bryanduxbury/atx_bench/v1/README.md

# atx_bench

An digitally-adjustable bench power supply built around an ATX computer power supply.

Check out the DATASHEET for info on features.
