bryanduxbury/atx_bench/(list of files, cad)

Other CAD files:
v1/scad/arduino.scad
