bryanduxbury/atx_bench/v1/eagle/mainboard_v1.brd

## EAGLE design v1/eagle/mainboard_v1.brd (2015-08-13)

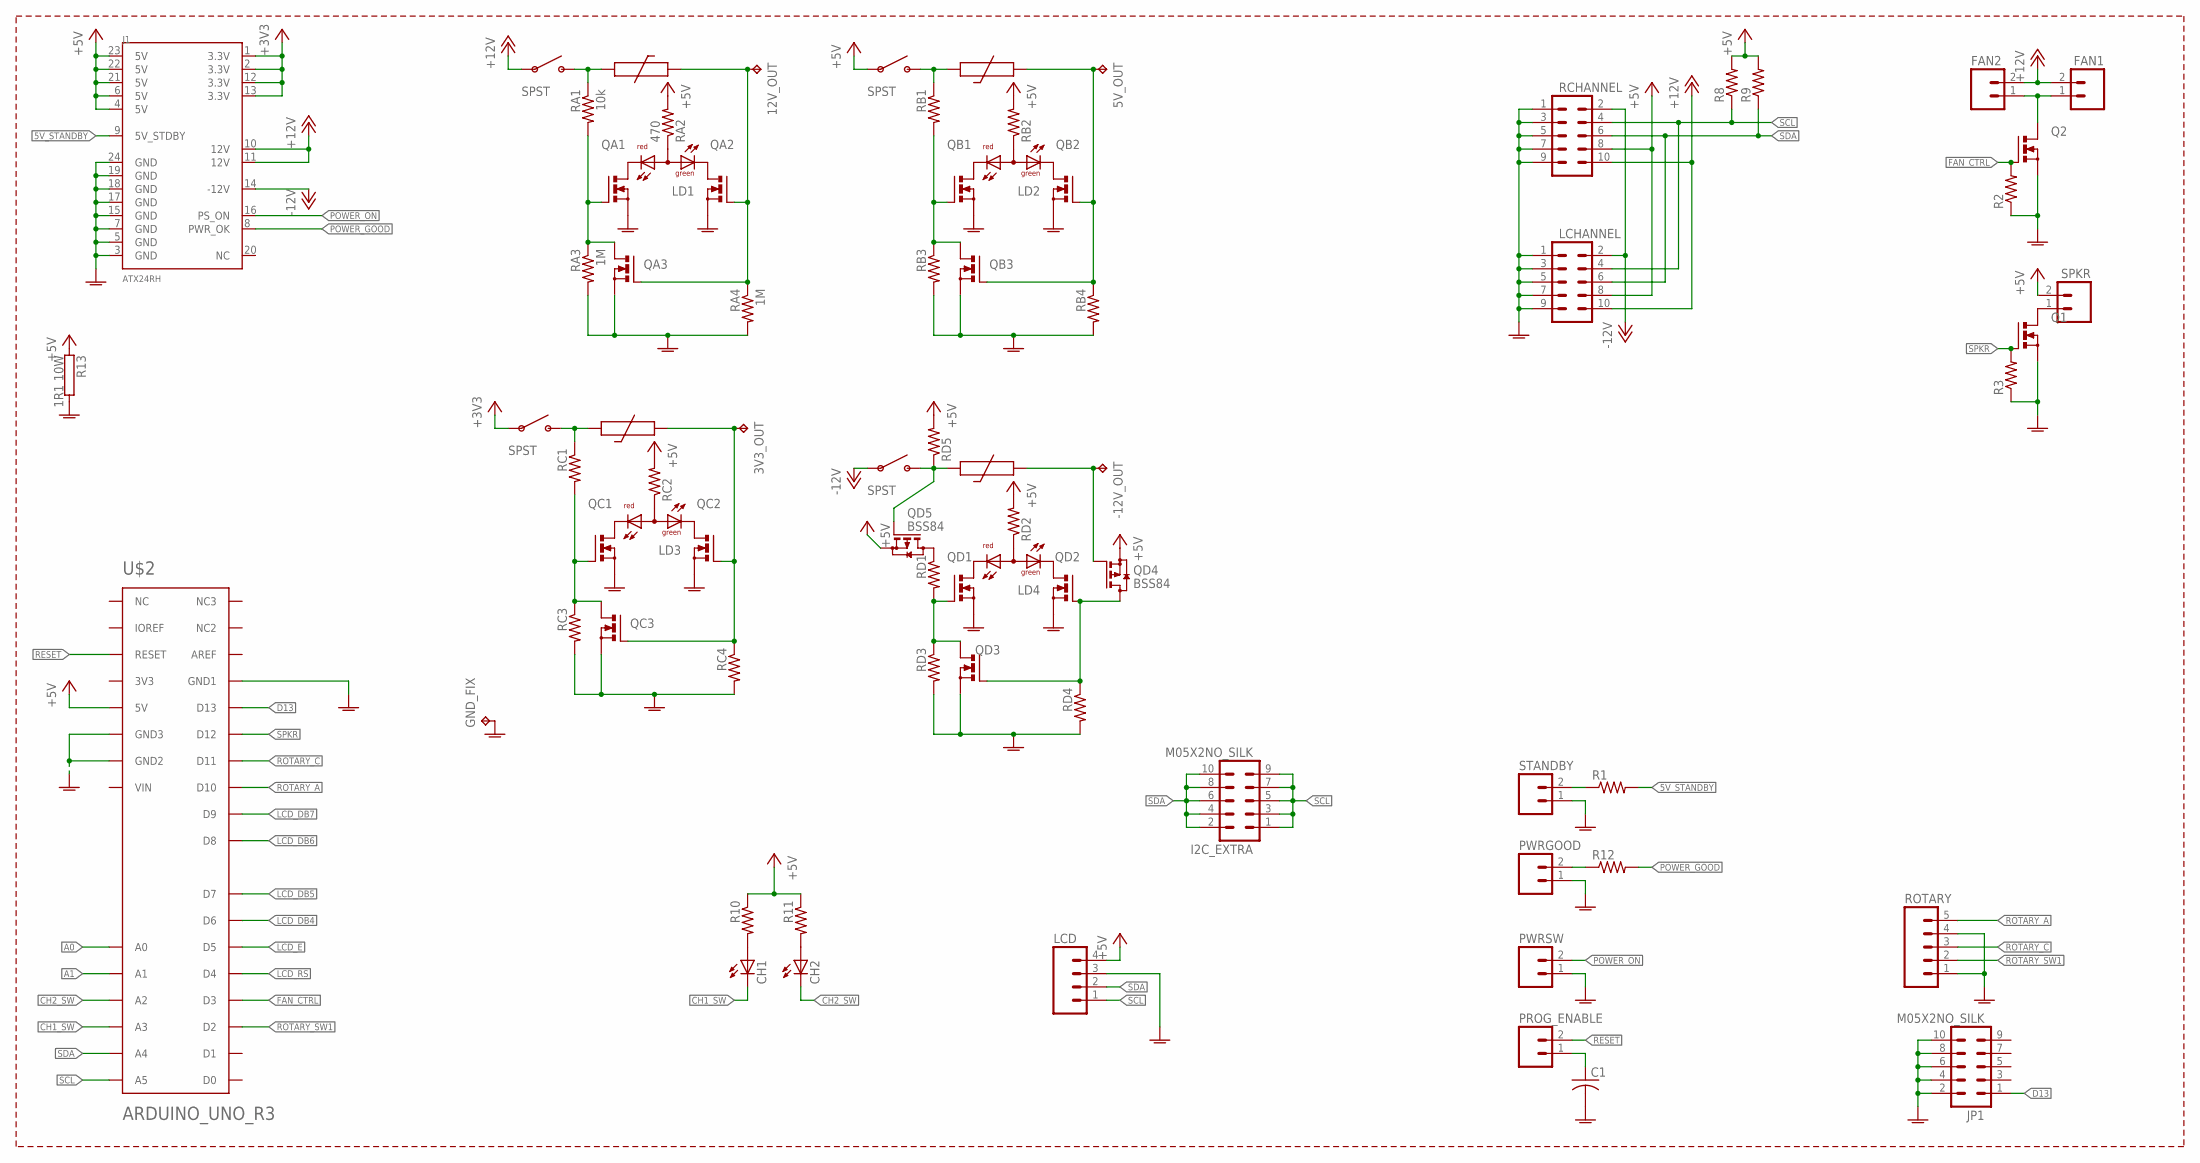
[picture p1: schematic mainboard_v1.sch]

Parts:
3V3_OUT, 5V_OUT, 12V_OUT: TPPAD1-20; P1-20
-12V_OUT: TPPAD1-20; P1-20
C1: C-USC0805; C0805
CH1, CH2: LED5MM
FAN1, FAN2: M02PTH; 1X02
GND_FIX: TPPAD1-20; P1-20
I2C_EXTRA: M05X2NO_SILK; 2X5_NOSILK
J1: ATX24RH; ATX24_RIGHT_ANGLE
JP1: M05X2NO_SILK; 2X5_NOSILK
LCD: M04; 04P
LCHANNEL: M05X2SHD; 2X5-SHROUDED
LD1, LD2, LD3, LD4: DUOLED-RG-A; DUOLED-A-5MM
PROG_ENABLE: M02PTH; 1X02
PWRGOOD: M02PTH; 1X02
PWRSW: M02PTH; 1X02
Q1, Q2: 2N7002L; SOT23
QA1, QA2, QA3: 2N7002L; SOT23
QB1, QB2, QB3: 2N7002L; SOT23
QC1, QC2, QC3: 2N7002L; SOT23
QD1, QD2, QD3: 2N7002L; SOT23
QD4, QD5: BSS84; SOT23
R1, R2, R3, R8, R9, R10, R11, R12: R-US_R0805; R0805
R13: 1R1 10W; MNS-5
RA1: 10k; R0805
RA2: 470; R0805
RA3, RA4: 1M; R0805
RB1, RB2, RB3, RB4: R-US_R0805; R0805
RC1, RC2, RC3, RC4: R-US_R0805; R0805
RCHANNEL: M05X2SHD; 2X5-SHROUDED
RD1, RD2, RD3, RD4, RD5: R-US_R0805; R0805
ROTARY: M05; 05P
SPKR: M02PTH; 1X02
STANDBY: M02PTH; 1X02
U$1, U$3, U$4, U$5: MF-R300; MR-300
U$2: ARDUINO_UNO_R3MINIMUM; ARDUINO_UNO_R3_MIN
U$6, U$8, U$9, U$10: SPST; 2P_REMOTE

Connections:
5V_OUT: 5V_OUT.TP, QB2.1 (G), QB3.1 (G), RB4.1, U$3.P$2 (2)
5V_OUT1: 3V3_OUT.TP, QC2.1 (G), QC3.1 (G), RC4.1, U$4.P$2 (2)
5V_STANDBY: J1.9 (5V_STDBY), R1.2
+3V3: J1.1 (3.3V), J1.2 (3.3V), J1.12 (3.3V), J1.13 (3.3V), U$9.1
+5V: J1.4 (5V), J1.6 (5V), J1.21 (5V), J1.22 (5V), J1.23 (5V), LCD.4, LCHANNEL.8, QD4.2 (S), QD5.2 (S), R8.2, R9.2, R10.1, R11.1, R13.1, RA2.2, RB2.2, RC2.2, RCHANNEL.8, RD2.2, RD5.2, SPKR.2, U$2.5V, U$8.1
+12V: FAN1.2, FAN2.2, J1.10 (12V), J1.11 (12V), LCHANNEL.10, RCHANNEL.10, U$6.1
-12V: J1.14 (-12V), LCHANNEL.2, RCHANNEL.2, U$10.1
A0: U$2.A0
A1: U$2.A1
CH1_SW: CH1.K (C), U$2.A3
CH2_SW: CH2.K (C), U$2.A2
D13: JP1.1, U$2.D13
FAN_CTRL: Q2.1 (G), R2.2, U$2.D3
GNDA: C1.2, GND_FIX.TP, J1.3 (GND), J1.5 (GND), J1.7 (GND), J1.15 (GND), J1.17 (GND), J1.18 (GND), J1.19 (GND), J1.24 (GND), JP1.2, JP1.4, JP1.6, JP1.8, JP1.10, LCD.3, LCHANNEL.1, LCHANNEL.3, LCHANNEL.5, LCHANNEL.7, LCHANNEL.9, PWRGOOD.1, PWRSW.1, Q1.2 (S), Q2.2 (S), QA1.2 (S), QA2.2 (S), QA3.2 (S), QB1.2 (S), QB2.2 (S), QB3.2 (S), QC1.2 (S), QC2.2 (S), QC3.2 (S), QD1.2 (S), QD2.2 (S), QD3.2 (S), R2.1, R3.1, R13.2, RA3.2, RA4.2, RB3.2, RB4.2, RC3.2, RC4.2, RCHANNEL.1, RCHANNEL.3, RCHANNEL.5, RCHANNEL.7, RCHANNEL.9, RD3.2, RD4.2, ROTARY.1, ROTARY.4, STANDBY.1, U$2.GND (GND1), U$2.GND2, U$2.GND3
LCD_DB4: U$2.D6
LCD_DB5: U$2.D7
LCD_DB6: U$2.D8
LCD_DB7: U$2.D9
LCD_E: U$2.D5
LCD_RS: U$2.D4
unnamed: FAN1.1, FAN2.1, Q2.3 (D)
unnamed: R1.1, STANDBY.2
unnamed: Q1.3 (D), SPKR.1
unnamed: CH1.A, R10.2
unnamed: CH2.A, R11.2
unnamed: LD2.A, RB2.1
unnamed: LD1.A, RA2.1
unnamed: LD1.CX (CG), QA2.3 (D)
unnamed: LD1.CR, QA1.3 (D)
unnamed: LD2.CX (CG), QB2.3 (D)
unnamed: LD2.CR, QB1.3 (D)
unnamed: PWRGOOD.2, R12.1
unnamed: C1.1, PROG_ENABLE.1
unnamed: RA1.1, U$1.P$2 (2), U$6.2
unnamed: LD3.CR, QC1.3 (D)
unnamed: LD3.A, RC2.1
unnamed: LD3.CX (CG), QC2.3 (D)
unnamed: QD1.1 (G), QD3.3 (D), RD1.2, RD3.1
unnamed: QD5.3 (D), RD1.1
unnamed: LD4.CR, QD1.3 (D)
unnamed: 12V_OUT.TP, QA2.1 (G), QA3.1 (G), RA4.1, U$1.P$1 (1)
unnamed: QB1.1 (G), QB3.3 (D), RB1.2, RB3.1
unnamed: RB1.1, U$3.P$1 (1), U$8.2
unnamed: LD4.A, RD2.1
unnamed: QA1.1 (G), QA3.3 (D), RA1.2, RA3.1
unnamed: LD4.CX (CG), QD2.3 (D)
unnamed: QC1.1 (G), QC3.3 (D), RC1.2, RC3.1
unnamed: RC1.1, U$4.P$1 (1), U$9.2
unnamed: -12V_OUT.TP, QD4.1 (G), U$5.P$2 (2)
unnamed: QD5.1 (G), RD5.1, U$5.P$1 (1), U$10.2
unnamed: QD2.1 (G), QD3.1 (G), QD4.3 (D), RD4.1
POWER_GOOD: J1.8 (PWR_OK), R12.2
POWER_ON: J1.16 (PS_ON), PWRSW.2
RESET: PROG_ENABLE.2, U$2.RESET
ROTARY_A: ROTARY.5, U$2.D10
ROTARY_C: ROTARY.3, U$2.D11
ROTARY_SW1: ROTARY.2, U$2.D2
SCL: I2C_EXTRA.1, I2C_EXTRA.3, I2C_EXTRA.5, I2C_EXTRA.7, I2C_EXTRA.9, LCD.1, LCHANNEL.4, R8.1, RCHANNEL.4, U$2.A5
SDA: I2C_EXTRA.2, I2C_EXTRA.4, I2C_EXTRA.6, I2C_EXTRA.8, I2C_EXTRA.10, LCD.2, LCHANNEL.6, R9.1, RCHANNEL.6, U$2.A4
SPKR: Q1.1 (G), R3.2, U$2.D12

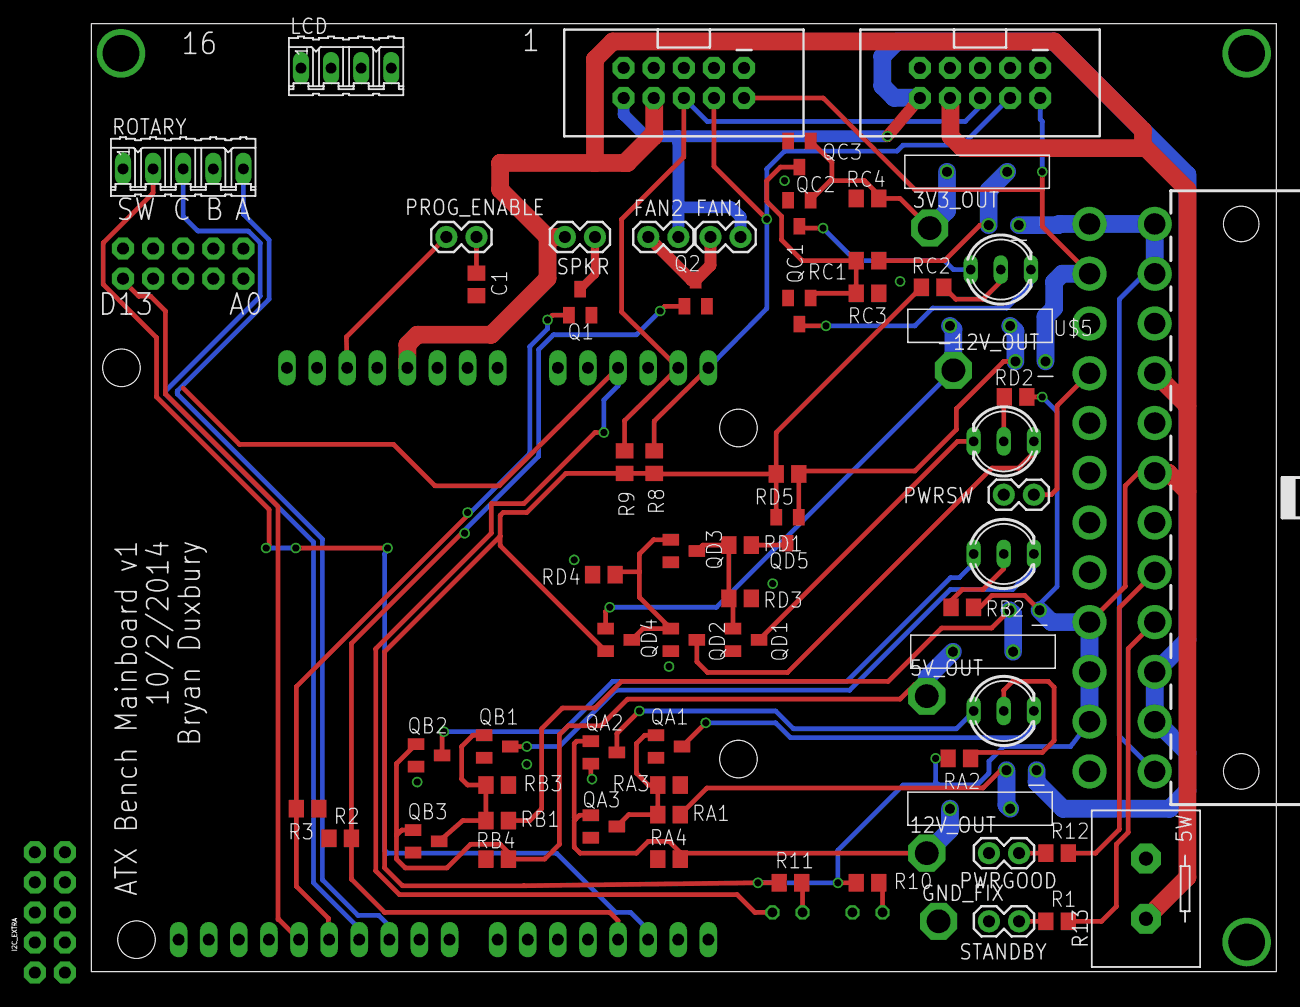
[picture p2: board mainboard_v1.brd from above]

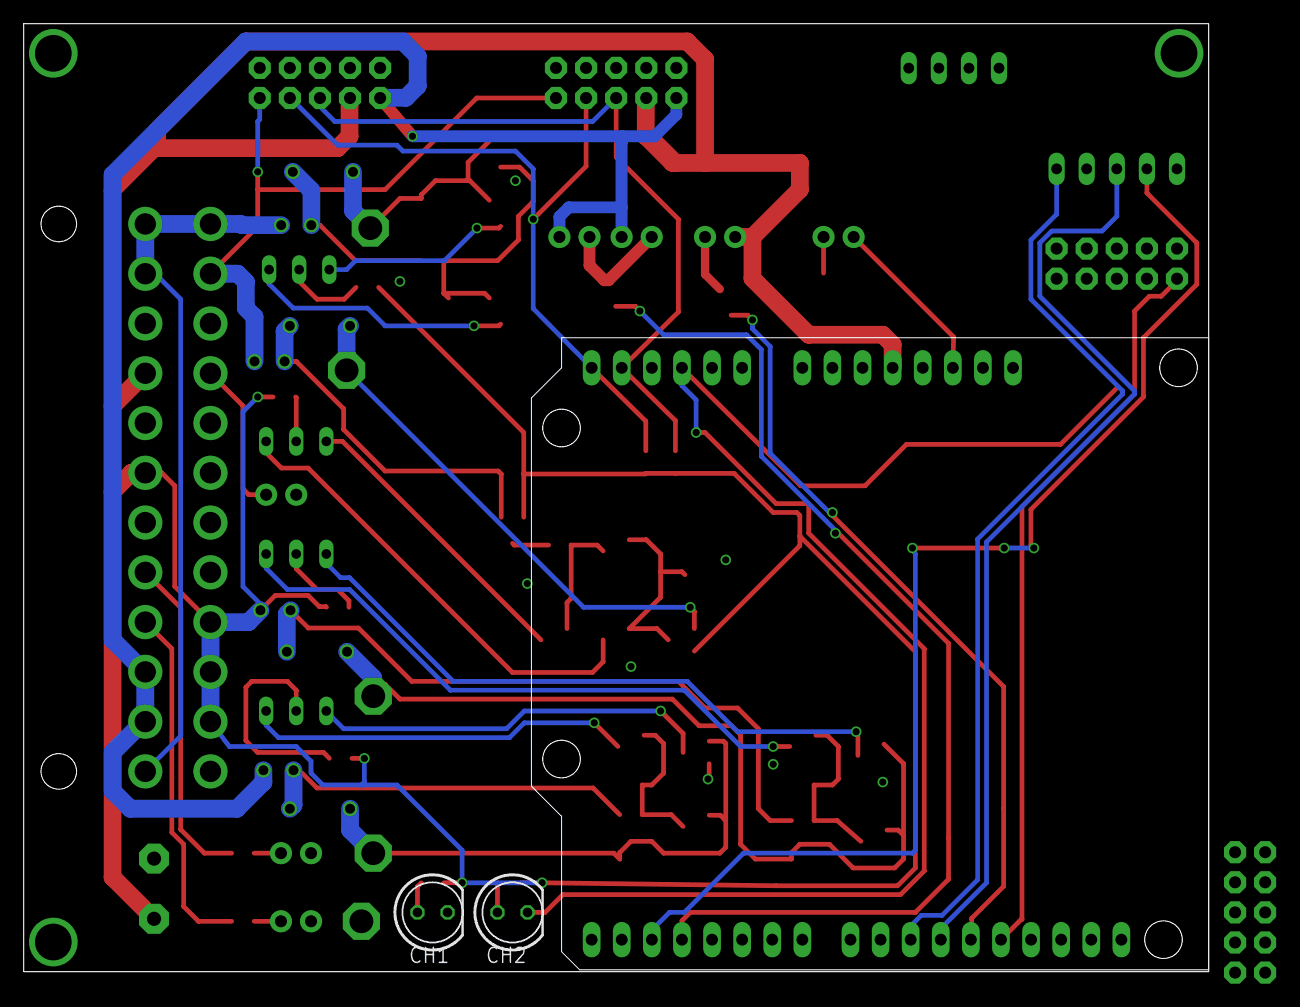
[picture p3: board mainboard_v1.brd from below]

Board: 2 copper layers, 100.0 x 80.0 mm, 77 parts (3 on the bottom side), 52 nets.
