bryanduxbury/atx_bench/v1/eagle/frontend_v1.brd

## EAGLE design v1/eagle/frontend_v1.brd (2014-10-03)

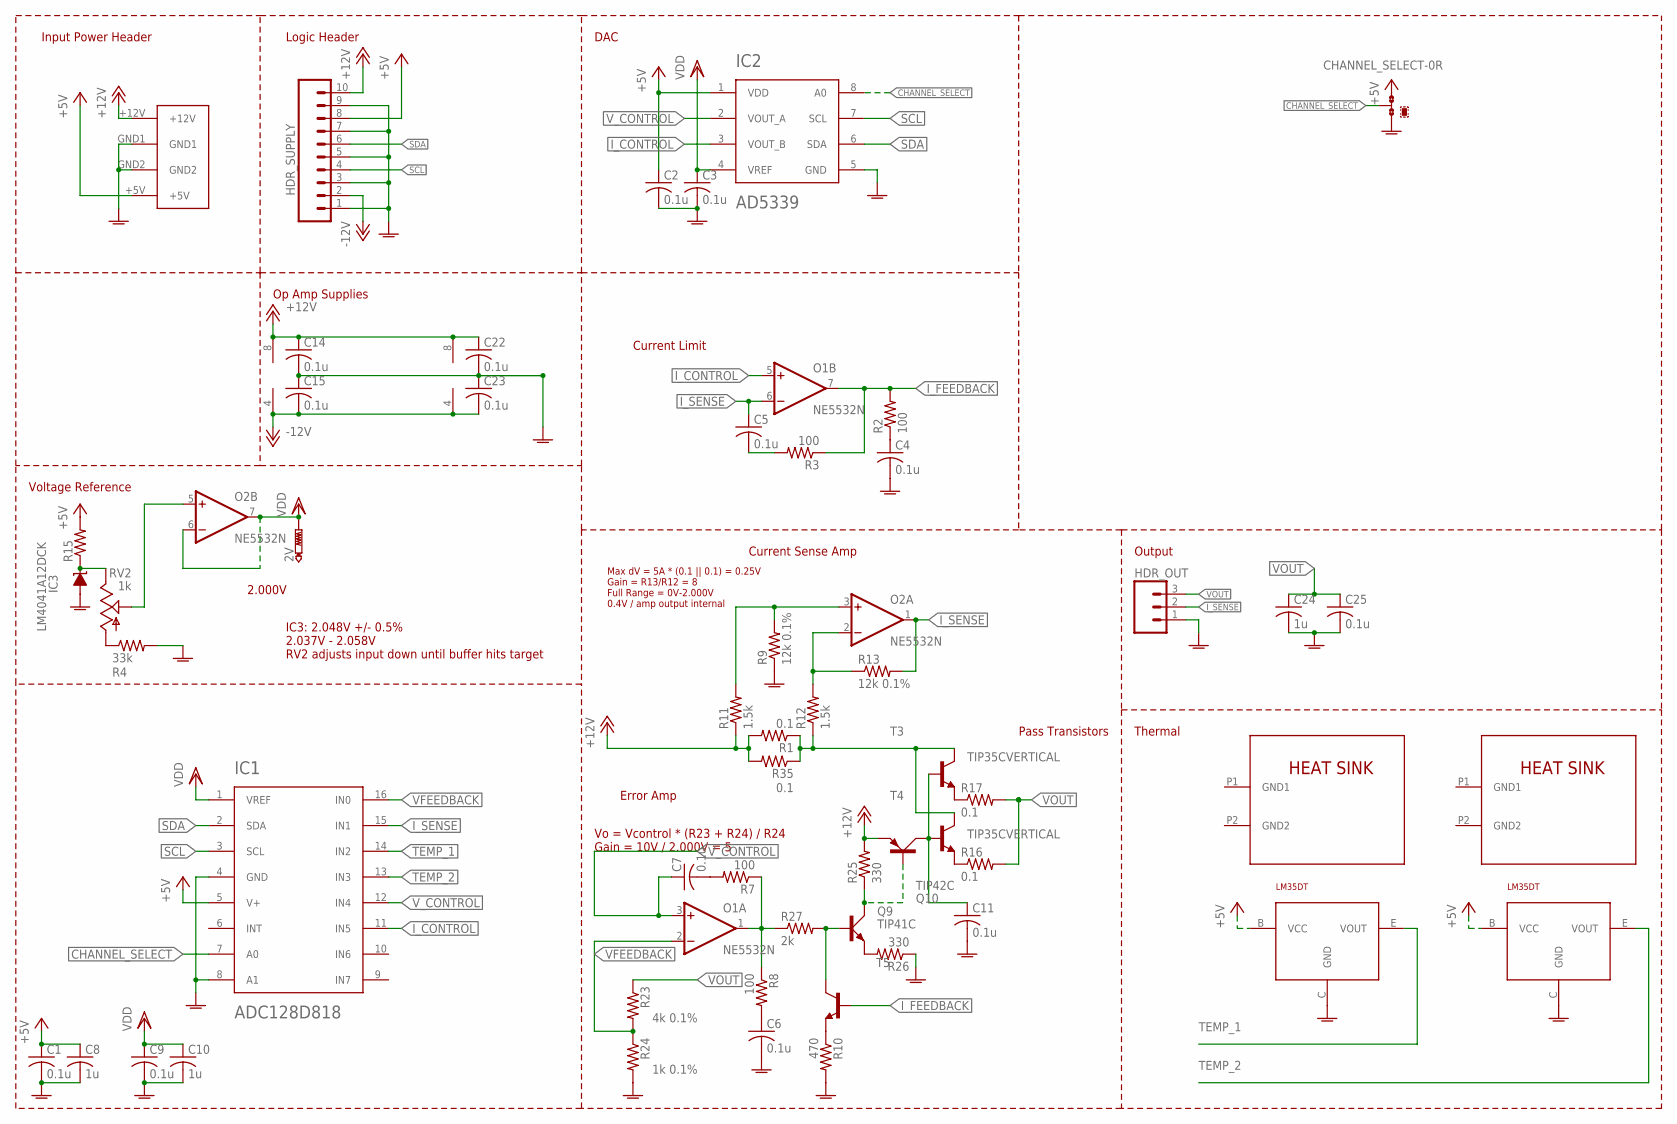
[picture p4: schematic frontend_v1.sch]

Parts:
2V: PTR1PAD1-17; P1-17
C1, C2, C3, C4, C5, C6, C7, C9, C11, C14, C15, C22, C23: 0.1u; C0805
C8, C10: 1u; C0805
C24: 1u; C1206
C25: 0.1u; C1206
CHANNEL_SELECT: 0R-JUMPA; A0R-JMP
HDR_OUT: M03; 03P
HDR_SUPPLY: M10; 10P
IC1: ADC128D818; TSSOP16
IC2: AD5339MSOP8; MSOP08
IC3: LM4041A12DCK; DCK_R-PDSO-G5
O1, O2: NE5532N; DIL08
Q9: TIP41C; TO220AV
Q10: TIP42C; TO220AV
R1, R16, R17, R35: 0.1; R2512
R2, R3, R7, R8: 100; M0805
R4: 33k; M0805
R9, R13: 12k 0.1%; M0805
R10: 470; M0805
R11, R12: 1.5k; M0805
R15: R-US_M0805; M0805
R23: 4k 0.1%; M0805
R24: 1k 0.1%; M0805
R25, R26: 330; M0805
R27: 2k; M0805
RV2: 1k; TRIM_POT
T3, T4: TIP35CVERTICAL; TO247
T5: MMBT2222ALT1-NPN-SOT23-BEC; SOT23-BEC
U2, U3: LM35DT; TO220AV
U$1: MOLEX-8981; MOLEX-8981-MALE
U$2, U$3: FA-T220-X

Connections:
+5V: C1.1, C2.1, C8.1, CHANNEL_SELECT.3, HDR_SUPPLY.8, IC1.5 (V+), IC2.1 (VDD), R15.2, U2.B (VCC), U3.B (VCC), U$1.+5V
+12V: C14.1, C22.1, HDR_SUPPLY.10, O1.8 (V+), O2.8 (V+), Q10.E, R1.2, R11.1, R25.2, R35.2, U$1.+12V
-12V: C15.2, C23.2, HDR_SUPPLY.2, O1.4 (V-), O2.4 (V-)
CHANNEL_SELECT: CHANNEL_SELECT.2, IC1.7 (A0), IC2.8 (A0)
GNDA: C1.2, C2.2, C3.2, C4.2, C6.2, C8.2, C9.2, C10.2, C11.2, C14.2, C15.1, C22.2, C23.1, C24.2, C25.2, CHANNEL_SELECT.1, HDR_OUT.1, HDR_SUPPLY.1, HDR_SUPPLY.3, HDR_SUPPLY.5, HDR_SUPPLY.7, HDR_SUPPLY.9, IC1.4 (GND), IC1.8 (A1), IC2.5 (GND), IC3.1 (A), R4.2, R9.1, R10.2, R24.2, R26.1, U2.C (GND), U3.C (GND), U$1.GND1, U$1.GND2
I_CONTROL: IC1.11 (IN5), IC2.3 (VOUT_B), O1.5 (+IN)
I_FEEDBACK: O1.7 (OUT), R2.2, R3.1, T5.B
I_SENSE: C5.1, HDR_OUT.2, IC1.15 (IN1), O1.6 (-IN), O2.1 (OUT), R13.2
unnamed: C4.1, R2.1
unnamed: C5.2, R3.2
unnamed: O2.5 (+IN), RV2.1 (S)
unnamed: R4.1, RV2.3 (A)
unnamed: C6.1, R8.2
unnamed: Q9.B, R27.2, T5.C
unnamed: C7.2, R7.2
unnamed: O2.3 (+IN), R9.2, R11.2
unnamed: O2.2 (-IN), R12.2, R13.1
unnamed: R10.1, T5.E
unnamed: R16.1, T4.P3 (E)
unnamed: R17.1, T3.P3 (E)
unnamed: R1.1, R12.1, R35.1, T3.P2 (C), T4.P2 (C)
unnamed: Q9.C, Q10.B, R25.1
unnamed: Q9.E, R26.2
unnamed: O1.1 (OUT), R7.1, R8.1, R27.1
unnamed: IC3.3 (C), R15.1, RV2.2 (E)
SCL: HDR_SUPPLY.4, IC1.3 (SCL), IC2.7 (SCL)
SDA: HDR_SUPPLY.6, IC1.2 (SDA), IC2.6 (SDA)
TEMP_1: IC1.14 (IN2), U2.E (VOUT)
TEMP_2: IC1.13 (IN3), U3.E (VOUT)
VDD: 2V.TP, C3.1, C9.1, C10.1, IC1.1 (VREF), IC2.4 (VREF), O2.6 (-IN), O2.7 (OUT)
VFEEDBACK: IC1.16 (IN0), O1.2 (-IN), R23.2, R24.1
VOUT: C24.1, C25.1, HDR_OUT.3, R16.2, R17.2, R23.1
VREF: C11.1, Q10.C, T3.P1 (B), T4.P1 (B)
V_CONTROL: C7.1, IC1.12 (IN4), IC2.2 (VOUT_A), O1.3 (+IN)

Notes on the sheet:
Logic Header
Voltage Reference
Op Amp Supplies
Current Sense Amp
Error Amp
Pass Transistors
Current Limit
Output
Input Power Header
2.000V
Thermal
Max dV = 5A * (0.1 || 0.1) = 0.25V Gain = R13/R12 = 8 Full Range = 0V-2.000V 0.4V / amp output internal
IC3: 2.048V +/- 0.5% 2.037V - 2.058V RV2 adjusts input down until buffer hits target
Vo = Vcontrol * (R23 + R24) / R24 Gain = 10V / 2.000V = 5
DAC

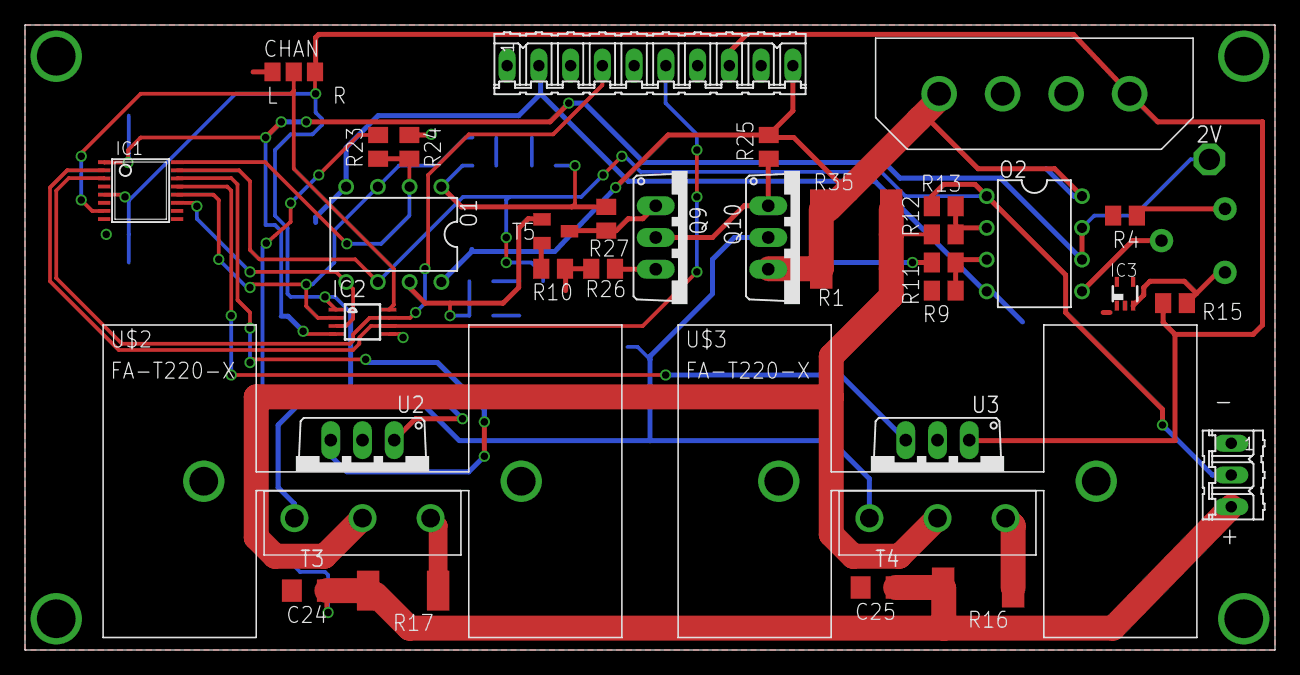
[picture p5: board frontend_v1.brd from above]

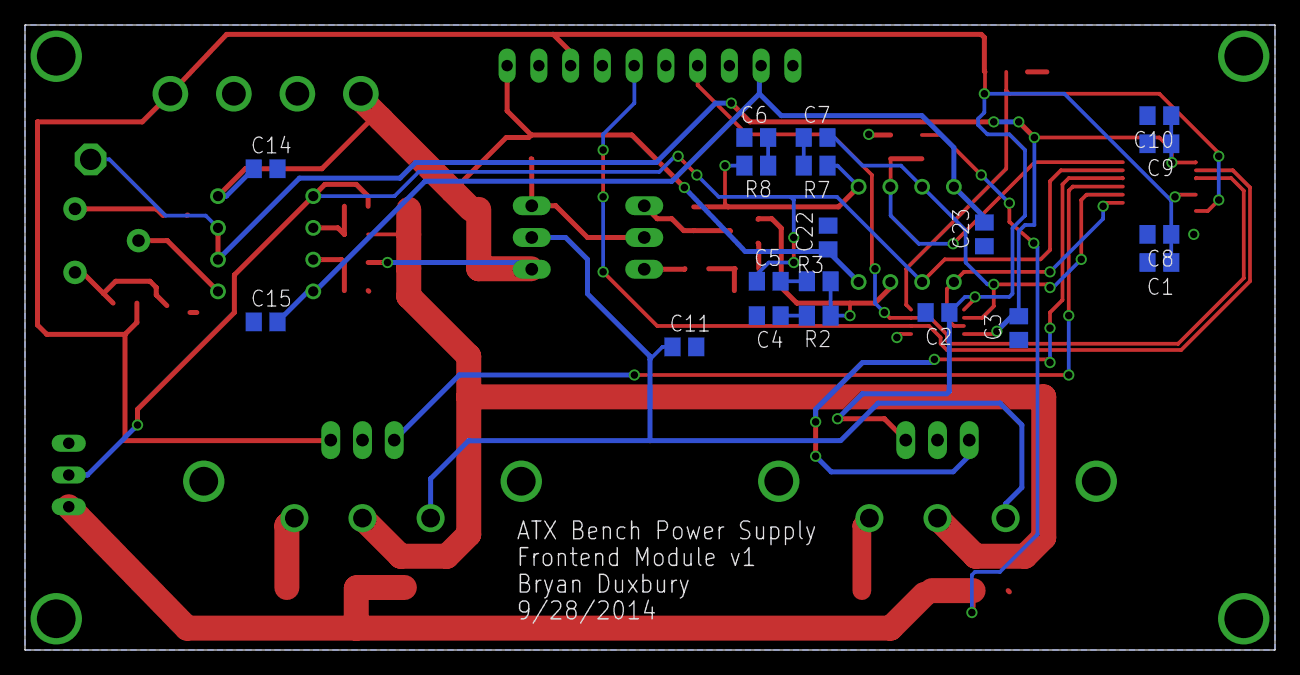
[picture p6: board frontend_v1.brd from below]

Board: 2 copper layers, 100.0 x 50.0 mm, 57 parts (19 on the bottom side), 34 nets.
