bryanduxbury/atx_bench/v1/dac_test/dac_test.ino

#define DAC_OUT 10

void setup() {
  pinMode(DAC_OUT, OUTPUT);
  analogReference(EXTERNAL);
  setPwmFrequency(DAC_OUT, 1);
  
  Serial.begin(115200);
}

void loop() {
  // sweepAndMeasureTest();
  serialControlTest();
}

void sweepAndMeasureTest() {
  while(1) {
    for (int i = 0; i < 256; i++) {
      Serial.print(i);

      analogWrite(DAC_OUT, i);

      for (int sampleNum = 0; sampleNum < 10; sampleNum++) {
        int measurement = analogRead(0);
        Serial.print(",");
        Serial.print(measurement);
        delay(100);
      }
      Serial.println();

      delay(100);
    }
  }
}

void serialControlTest() {
  int val = 0;
  analogWrite(DAC_OUT, val);

  while (1) {
    if (Serial.available() > 0) {
      switch ((char)Serial.read()) {
        case 'k':
          if (val < 255) {
            val ++;
          }
          break;

        case 'j': 
          if (val > 0) {
            val --;
          }
          break;
        
        default: 
          Serial.println("unrecognized!");
          break;
      }
      Serial.println(val);
      analogWrite(DAC_OUT, val);
    }
    delay(20);
  }
}

/**
 * Divides a given PWM pin frequency by a divisor.
 * 
 * The resulting frequency is equal to the base frequency divided by
 * the given divisor:
 *   - Base frequencies:
 *      o The base frequency for pins 3, 9, 10, and 11 is 31250 Hz.
 *      o The base frequency for pins 5 and 6 is 62500 Hz.
 *   - Divisors:
 *      o The divisors available on pins 5, 6, 9 and 10 are: 1, 8, 64,
 *        256, and 1024.
 *      o The divisors available on pins 3 and 11 are: 1, 8, 32, 64,
 *        128, 256, and 1024.
 * 
 * PWM frequencies are tied together in pairs of pins. If one in a
 * pair is changed, the other is also changed to match:
 *   - Pins 5 and 6 are paired on timer0
 *   - Pins 9 and 10 are paired on timer1
 *   - Pins 3 and 11 are paired on timer2
 * 
 * Note that this function will have side effects on anything else
 * that uses timers:
 *   - Changes on pins 3, 5, 6, or 11 may cause the delay() and
 *     millis() functions to stop working. Other timing-related
 *     functions may also be affected.
 *   - Changes on pins 9 or 10 will cause the Servo library to function
 *     incorrectly.
 * 
 * Thanks to macegr of the Arduino forums for his documentation of the
 * PWM frequency divisors. His post can be viewed at:
 *   http://www.arduino.cc/cgi-bin/yabb2/YaBB.pl?num=1235060559/0#4
 */
void setPwmFrequency(int pin, int divisor) {
  byte mode;
  if(pin == 5 || pin == 6 || pin == 9 || pin == 10) {
    switch(divisor) {
      case 1: mode = 0x01; break;
      case 8: mode = 0x02; break;
      case 64: mode = 0x03; break;
      case 256: mode = 0x04; break;
      case 1024: mode = 0x05; break;
      default: return;
    }
    if(pin == 5 || pin == 6) {
      TCCR0B = TCCR0B & 0b11111000 | mode;
    } else {
      TCCR1B = TCCR1B & 0b11111000 | mode;
    }
  } else if(pin == 3 || pin == 11) {
    switch(divisor) {
      case 1: mode = 0x01; break;
      case 8: mode = 0x02; break;
      case 32: mode = 0x03; break;
      case 64: mode = 0x04; break;
      case 128: mode = 0x05; break;
      case 256: mode = 0x06; break;
      case 1024: mode = 0x7; break;
      default: return;
    }
    TCCR2B = TCCR2B & 0b11111000 | mode;
  }
}
