bryanduxbury/atx_bench/(commit log)

2014-05-07 add initial scad work
    [external_parts.scad, v1.scad]
2014-05-07 eagle work so far
    [555_boost_converter_fixed_gain.sch, buck_boost_supply_module_v1.sch, mainboard_v1.sch, variable_supply_module_v1.sch]
2014-09-28 single-channel frontend ready to be sent out
    [frontend_v1.brd, frontend_v1.sch]
2014-09-28 very old doodles on a buck/boost style supply frontend
    [buck_boost_supply_module_v1.sch]
2014-09-28 all sorts of old ideas for how frontend would work
    [variable_supply_module_v2.sch, variable_supply_module_v3.brd, variable_supply_module_v3.sch]
2014-09-28 trash old schematics
    [variable_supply_module_v1.sch, variable_supply_module_v2.sch]
2014-09-28 added sketch to experiment with PWM + opamp DAC
2014-09-28 roughing out possible physical configuration
    [external_parts.scad, v1.scad]
2014-09-29 minor changes
    [frontend_v1.brd, frontend_v1.sch]
2014-10-03 mainboard is all laid out
    [mainboard_v1.brd, mainboard_v1.sch]
2014-10-03 added footprint for arduino
2014-10-03 slight changes for board house
    [frontend_v1.brd, frontend_v1.sch]
2014-10-04 seems like we've got a decent mockup of the physical layout
    [arduino.scad, external_parts.scad, v1.scad]
2014-10-26 adjustments to reflect newer mainboard design
    [external_parts.scad]
2014-10-26 sample sketch to experiment with DAC and ADC on frontend board
2015-08-13 outstanding work
    [mainboard_v1.brd, mainboard_v1.sch]
